thomasf10/bachelorproef_billy/Foto's en video's/IMG_20190320_094348.jpg

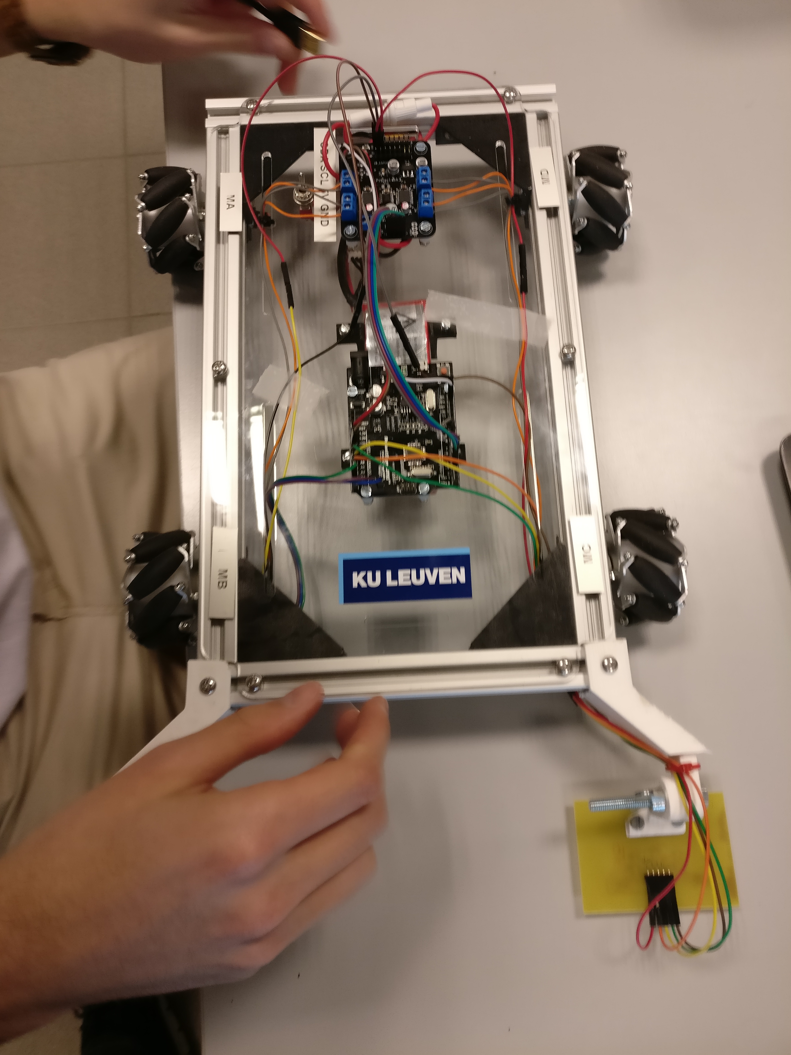
Foto's en video's/IMG_20190320_094348.jpg
