thomasf10/bachelorproef_billy/overzicht_gebruikte_pinnen.txt

chip:atmega328p-au 
pinnen:

1: D3:pwm| GEBRUIKT VOOR MOTORSHIELD				
2: D4 :WERKT OP PRINT
3: GND
4: VCC
5: VCC
6: VCC
7: XTAL1
8: XTAL2
9: D5:pwm| GEBRUIKT VOOR MOTORSHIELD
10: D6: pwm| GEBRUIKT VOOR MOTORSHIELD
11: D7 :WERKT OP PRINT
12: B0 (digitale i/o 8) | GEBRUIKT VOOR RFID RESET  :WERKT OP PRINT : moet misschien pwm pin zijn voor rfid!!!!!
13: B1:pwm (digitale i/o 9)| GEBRUIKT VOOR MOTORSHIELD
14: B2 (digitale i/o 10) | GEBRUIKT VOOR RFID SDA :WERKT OP PRINT
15: B3: pwm: mosi  (digitale i/o 11) | GEBRUIKT VOOR RFID MOSI :WERKT OP PRINT
16: B4: miso  (digitale i/o 12) | GEBRUIKT VOOR RFID MISO  :WERKT OP PRINT
17: B5: sck   (digitale i/o 13) | GEBRUIKT VOOR RFID SCK :WERKT OP PRINT
18: AVCC
19: A6: enkel analog in| GEBRUIKT VOOR SENSOR
20: AREF
21: GND
22: A7: enkel analog in| GEBRUIKT VOOR SENSOR
23: C0: (analog i/o 0)| GEBRUIKT VOOR SENSOR
24: C1: (analog i/o 1)| GEBRUIKT VOOR SENSOR
25: C2: (analog i/o 2)| GEBRUIKT VOOR SENSOR
26: C3: (analog i/o 3)| GEBRUIKT VOOR SENSOR
27: C4: SDA (analog i/o 4)| GEBRUIKT VOOR IO_EXPANDER/MOTORSHIELD
28: C5: SCL (analog i/o 5)| GEBRUIKT VOOR IO_EXPANDER/MOTORSHIELD
29: reset
30: D0: RX :WERKT OP PRINT
31: D1: TX :WERKT OP PRINT
32: D2 :WERKT OP PRINT
