thomasf10/bachelorproef_billy/random/gebruikteComponentenArduinoEnMotorDriver.txt

C:	10 uF		2 	elco's
	0.47 uF		2	elco's
	0.1 uF		3x  	gewoon
	10u		4x	gewoon
	2.2 uF			gewoon	
	100n 		6x	gewoon

pinnetjes

LED:	groen:		1x
	blauw:		4x

TCA9554PWR	2x		(io expander)
TB6612FNG	2x		(motor driver)

Degson input blokje

R:	470		5x
	10k		6x
	1		2x
	1M		1x

switch
Atmega328P-AU
CSTCE16MOV53-RO		oscillatorkristal
NCP1117			5V REGULLATOR --> andere uit labo
LP2985 -33DBVR		3.3 V regulator --> bestellen
