thomasf10/bachelorproef_billy/bachelor proef arno/schema in word.docx

5V naar 3.3 V omzetting

Ontkoppel condensatoren

ON/OFF LED

12V naar 5V omzetting

12V naar 5V omzetting


Pull-up weerstanden

Connectoren

Atmega328P


I/O-expanders


Motor drivers
