thomasf10/bachelorproef_billy/bachelor proef arno/arduino_unoModulo_second_version/models/README

De juiste informatie over componenten vind je op de site:
https://componentsearchengine.com/ga/index.html

Op de site Mouser zou ik de componenten willen bestellen
