thomasf10/bachelorproef_billy/Foto's en video's/IMG_20190306_163210.jpg

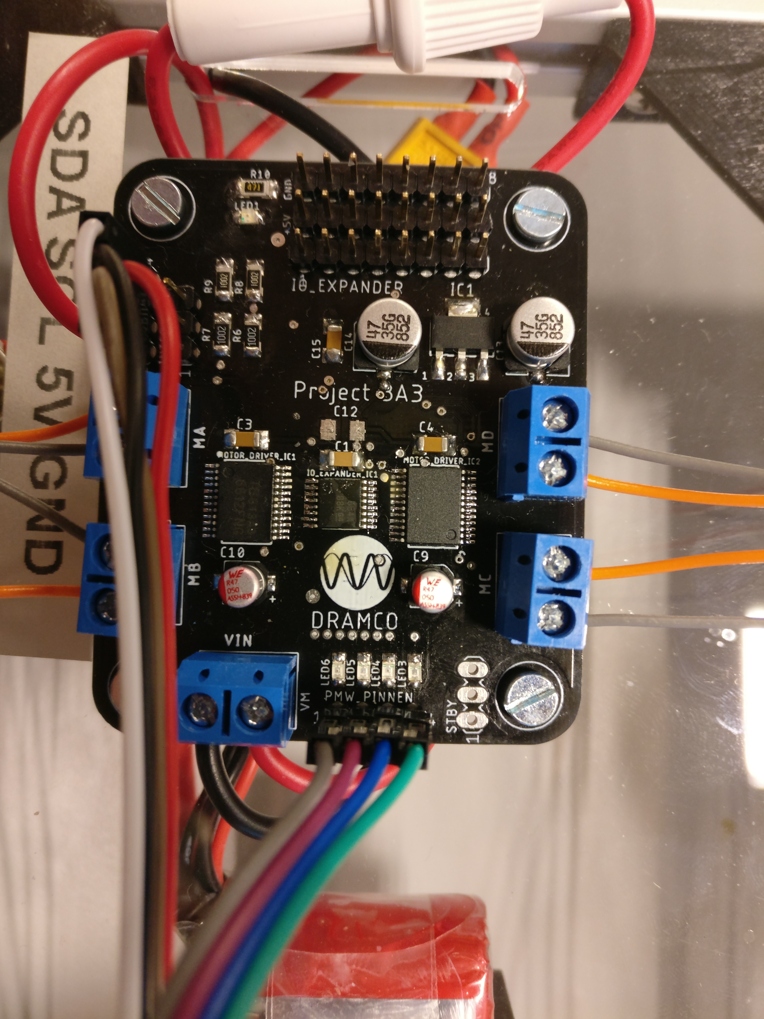
Foto's en video's/IMG_20190306_163210.jpg
