thomasf10/bachelorproef_billy/Foto's en video's/IMG_20190328_161647.jpg

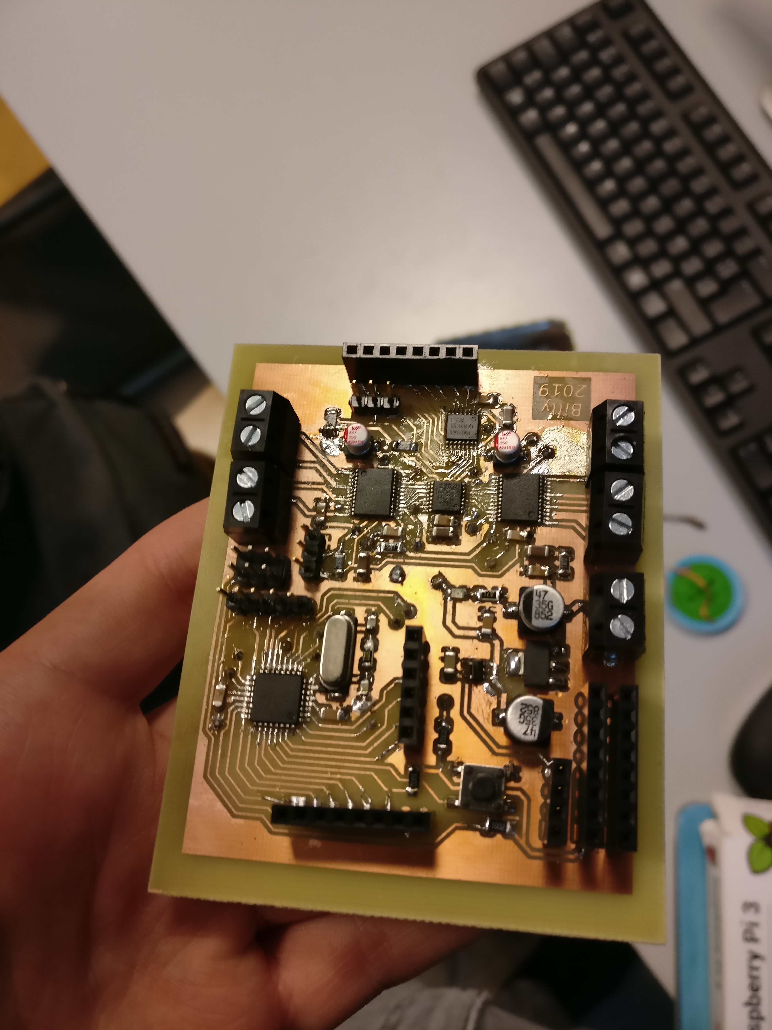
Foto's en video's/IMG_20190328_161647.jpg
