thomasf10/bachelorproef_billy/Foto's en video's/IMG_20190403_132421.jpg

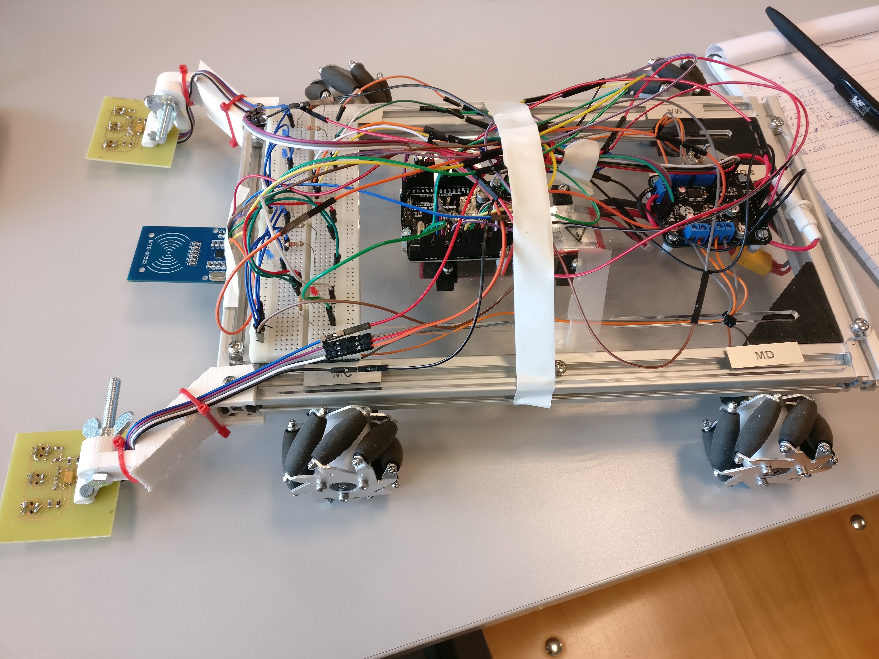
Foto's en video's/IMG_20190403_132421.jpg
