thomasf10/bachelorproef_billy/Foto's en video's/IMG_20190403_160422.jpg

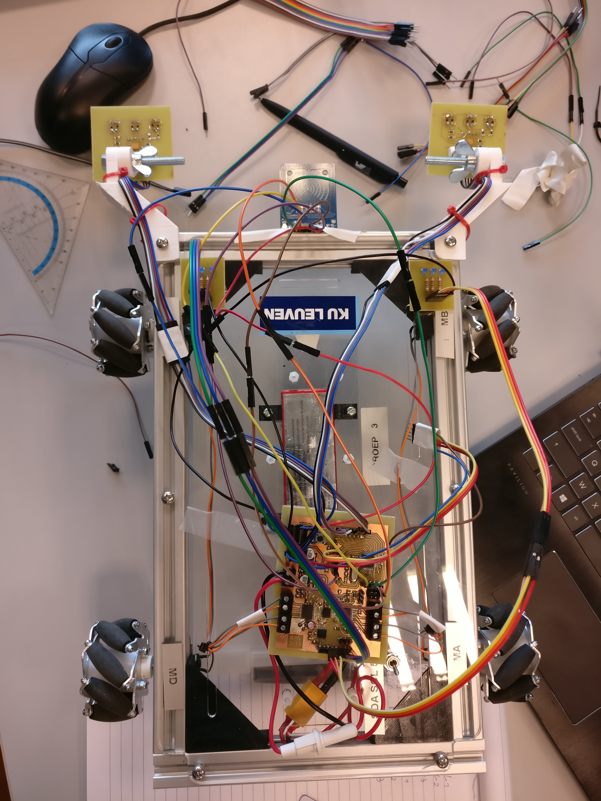
Foto's en video's/IMG_20190403_160422.jpg
