thomasf10/bachelorproef_billy/Foto's en video's/IMG_20190424_135959.jpg

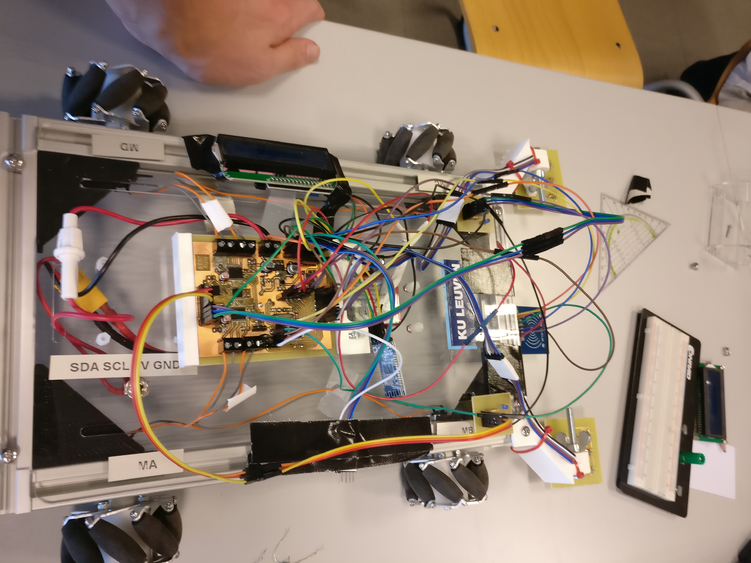
Foto's en video's/IMG_20190424_135959.jpg
