thomasf10/bachelorproef_billy/Foto's en video's/IMG_20190427_100022.jpg

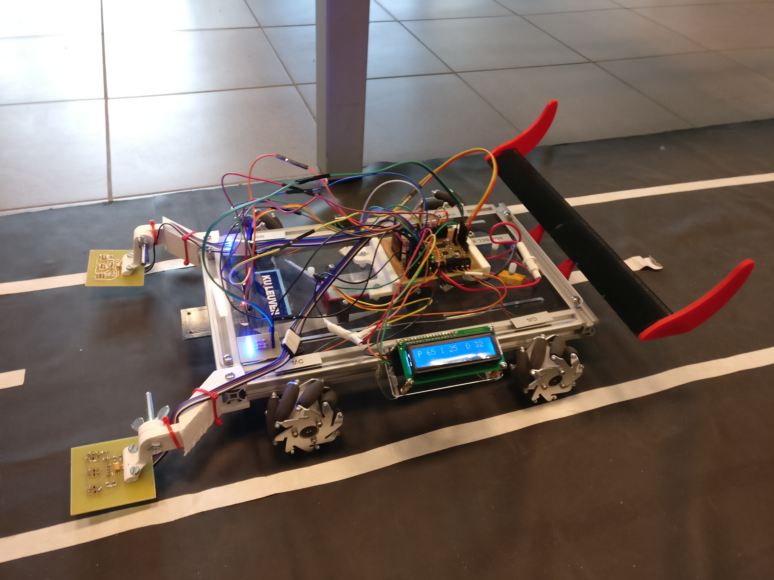
Foto's en video's/IMG_20190427_100022.jpg
