thomasf10/bachelorproef_billy/Foto's en video's/IMG_20190427_101007.jpg

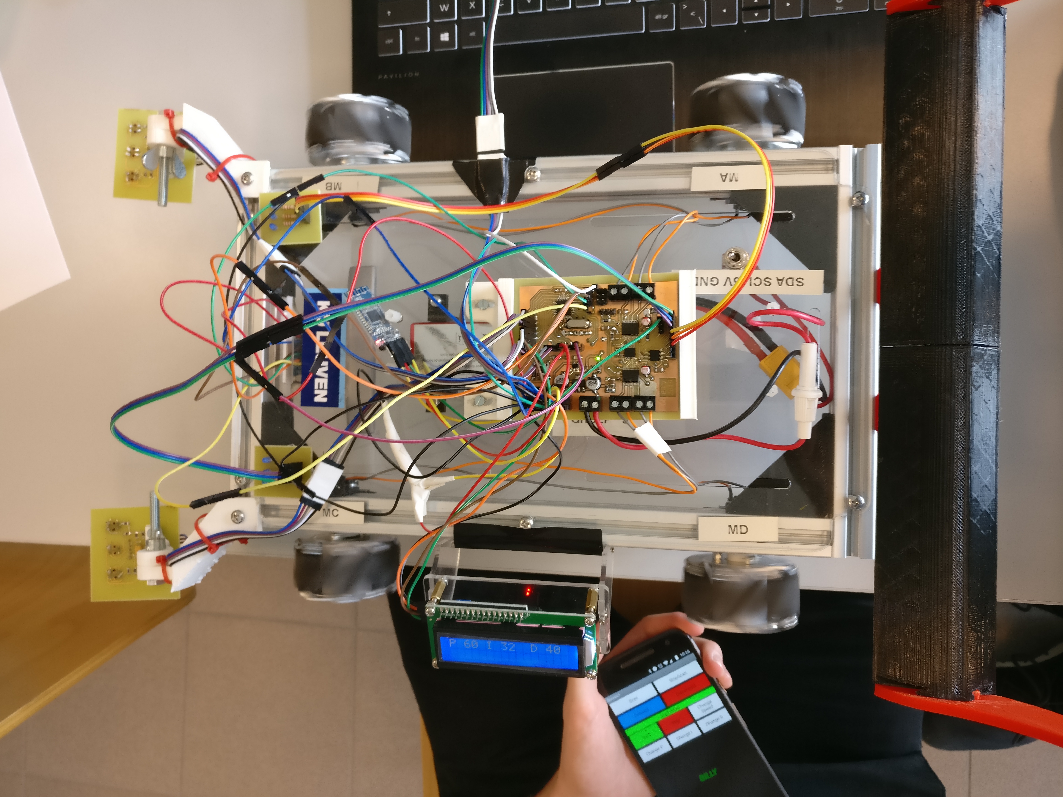
Foto's en video's/IMG_20190427_101007.jpg
