thomasf10/bachelorproef_billy/Foto's en video's/IMG_20190427_141029.jpg

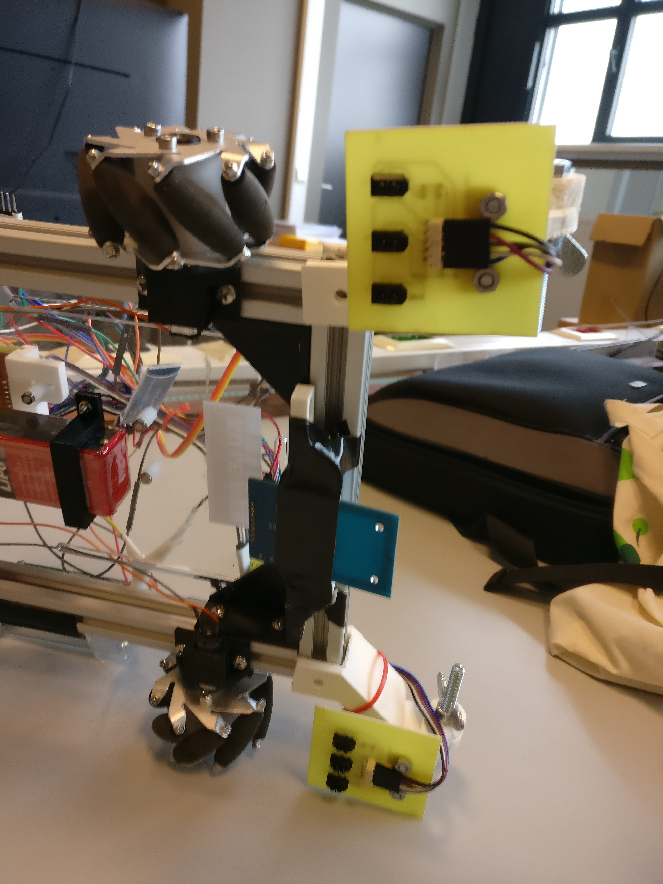
Foto's en video's/IMG_20190427_141029.jpg
