thomasf10/bachelorproef_billy/random/basis_errors.png

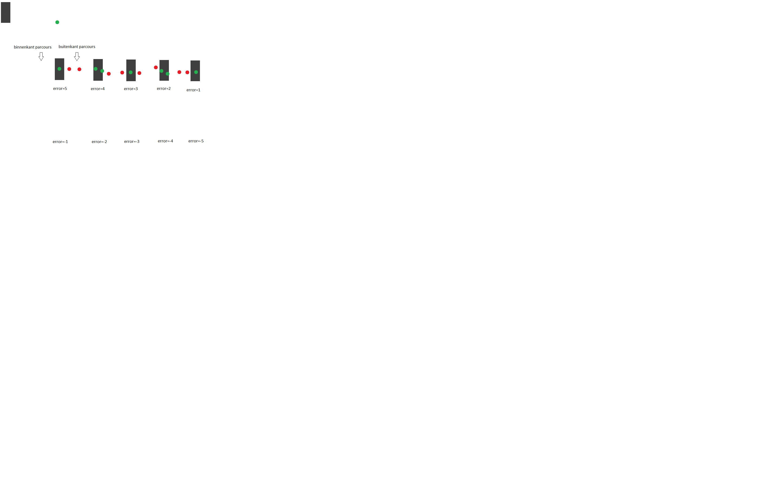
random/basis_errors.png
