thomasf10/bachelorproef_billy/random/Bestellijst1.JPG

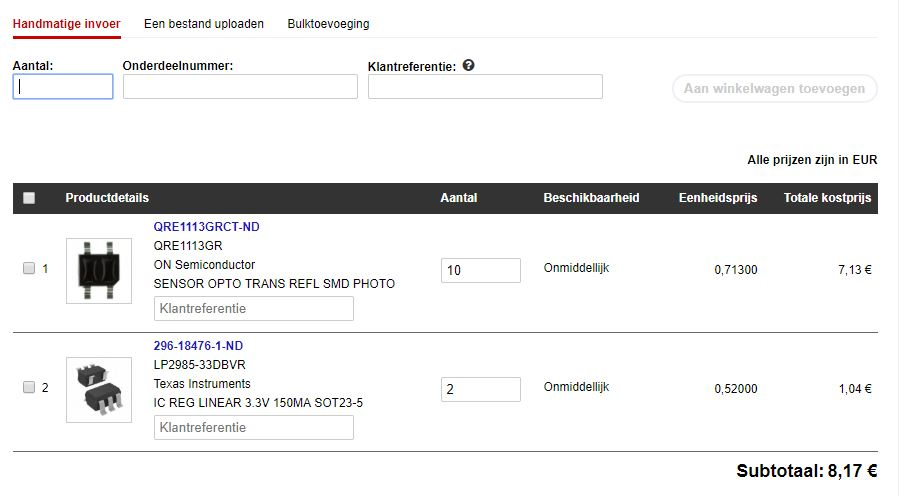
random/Bestellijst1.JPG
