thomasf10/bachelorproef_billy/random/bestellijst2.png

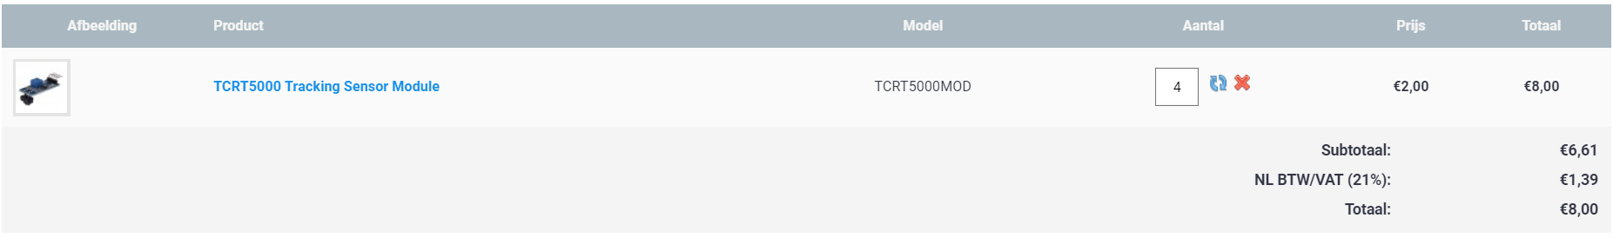
random/bestellijst2.png
