thomasf10/bachelorproef_billy/random/middenlijn.png

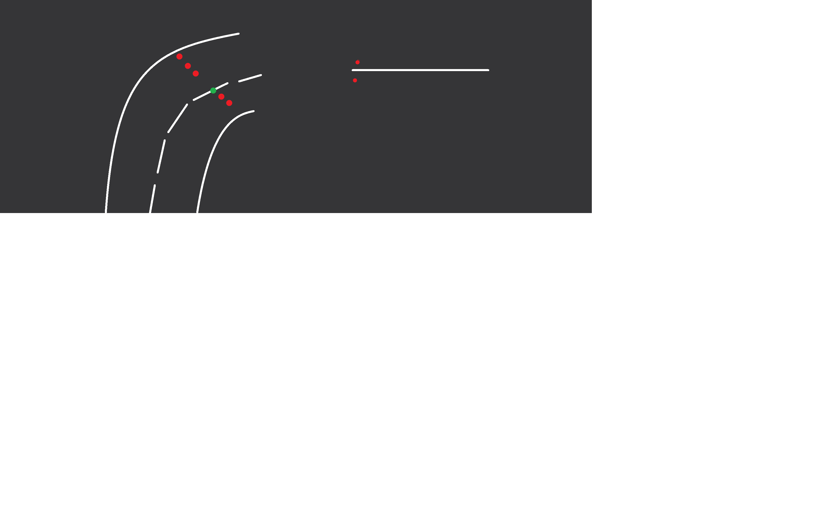
random/middenlijn.png
