thomasf10/bachelorproef_billy/random/rfidaansluiting.PNG

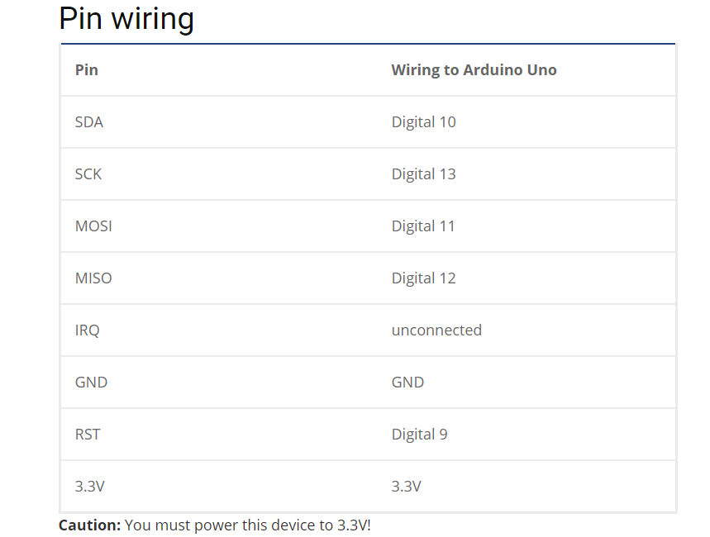
random/rfidaansluiting.PNG
