thomasf10/bachelorproef_billy/skidsteering_idee.PNG

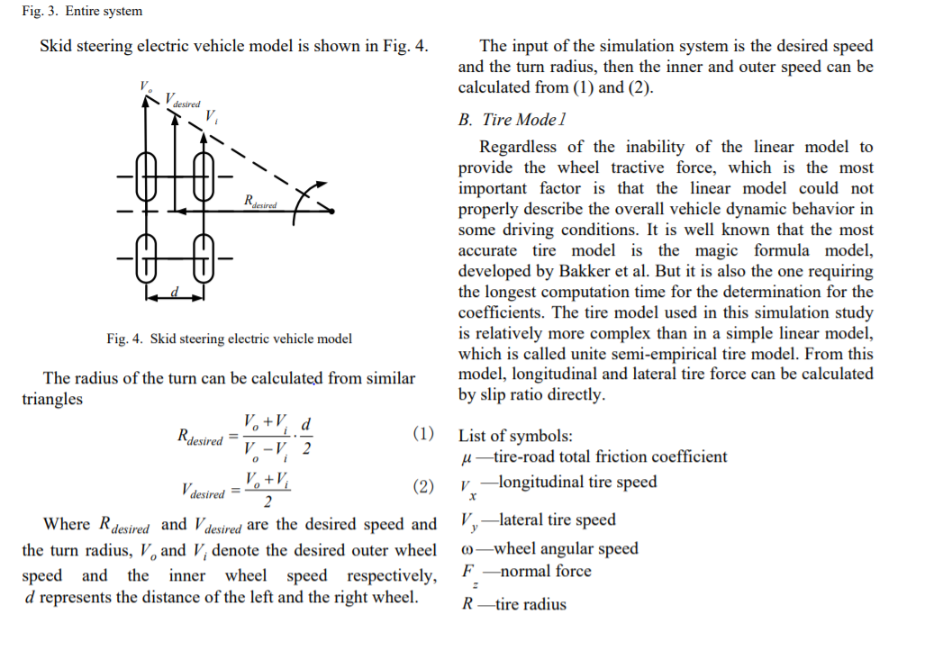
skidsteering_idee.PNG
