thomasf10/bachelorproef_billy/bachelor proef arno/arduino_unoModulo_second_version/models/LIB_ATMEGA328P-AU/ATMEGA328P-AU/3D/ATMEGA328P-AU.stp

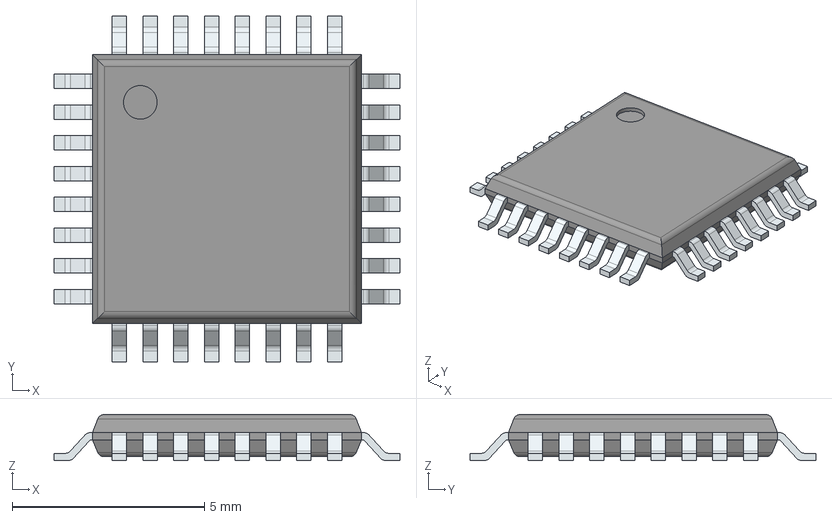
[picture p95: CAD file, 2019-03-08]
bachelor proef arno/arduino_unoModulo_second_version/models/LIB_ATMEGA328P-AU/ATMEGA328P-AU/3D/ATMEGA328P-AU.stp
9.00 x 9.00 x 1.20 mm
PinsArrayLR
PinsArrayTB
