thomasf10/bachelorproef_billy/bachelor proef arno/arduino_unoModulo_second_version/models/LIB_L298P/L298P/3D/L298P.stp

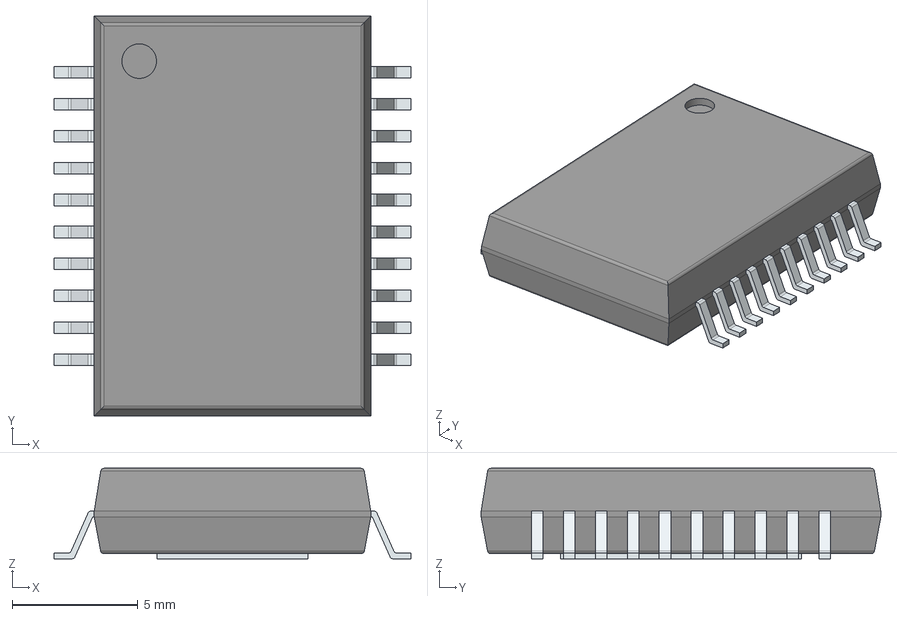
[picture p96: CAD file, 2019-03-08]
bachelor proef arno/arduino_unoModulo_second_version/models/LIB_L298P/L298P/3D/L298P.stp
14.2 x 15.9 x 3.60 mm
PinsArrayLR
ThermalPad
