thomasf10/bachelorproef_billy/bachelor proef arno/arduino_unoModulo_second_version/models/LIB_SK25AHM2G/SK25AHM2G/3D/SK25AHM2G.stp

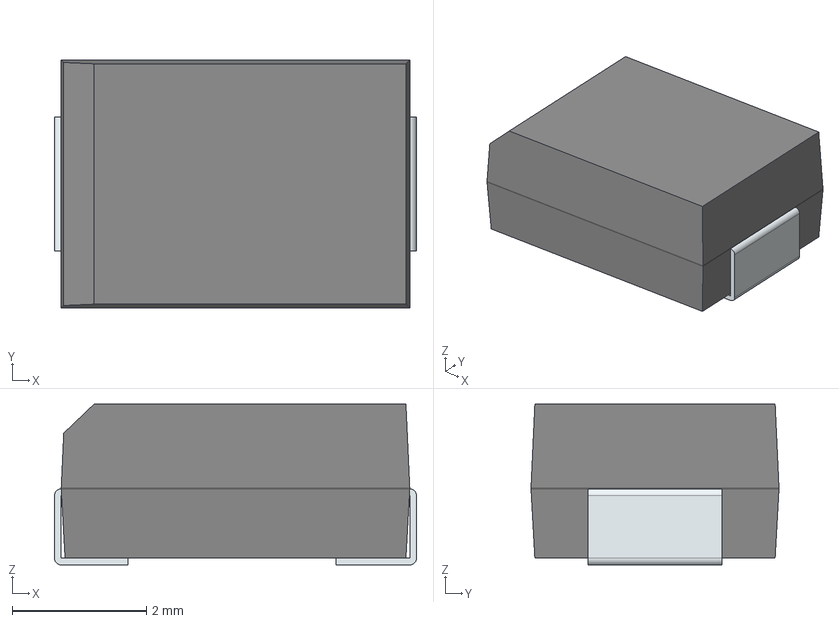
[picture p97: CAD file, 2019-03-08]
bachelor proef arno/arduino_unoModulo_second_version/models/LIB_SK25AHM2G/SK25AHM2G/3D/SK25AHM2G.stp
5.40 x 3.70 x 2.40 mm
FilletPin1
FilletPin2
