thomasf10/bachelorproef_billy/pcbholder/pcbholder.STL

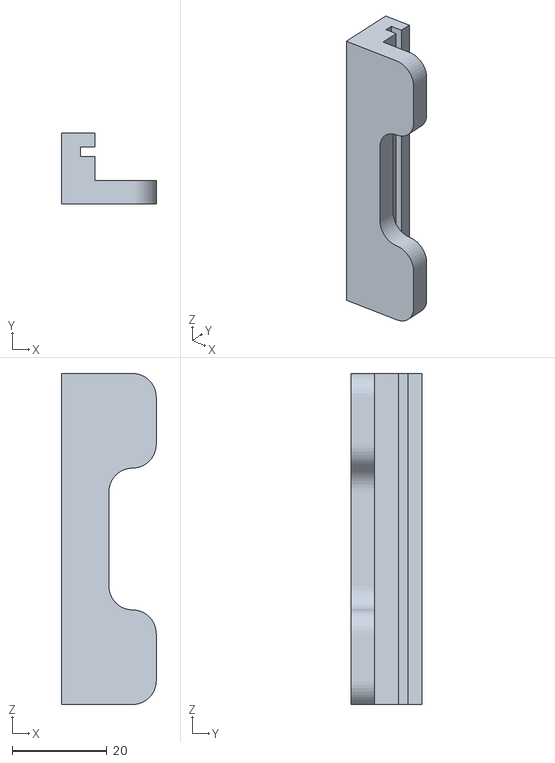
[picture p98: CAD file, 2019-04-03]
pcbholder/pcbholder.STL
20.0 x 15.0 x 70.0
