thomasf10/bachelorproef_billy/random/WielStuk.stl

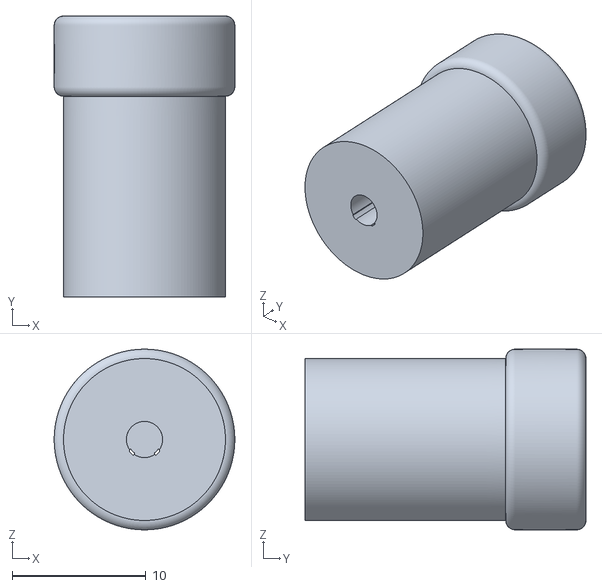
[picture p99: CAD file, 2019-04-30]
random/WielStuk.stl
13.5 x 21.0 x 13.5
