thomasf10/bachelorproef_billy/sensorarm/tussenstukV2.STL

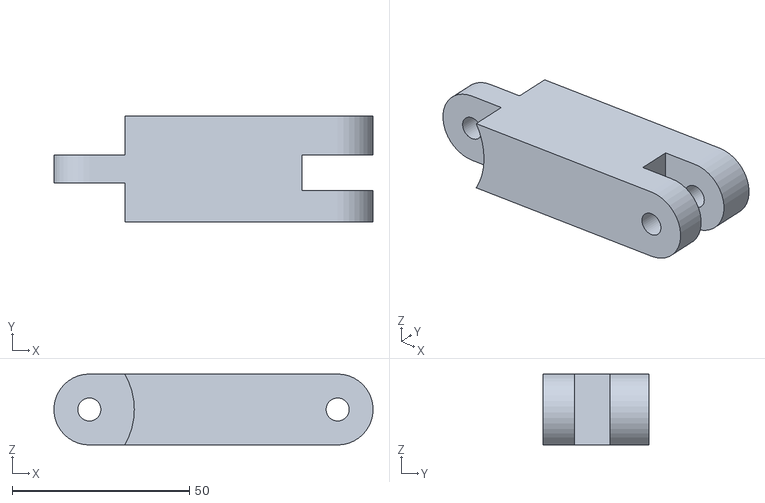
[picture p100: CAD file, 2019-03-06]
sensorarm/tussenstukV2.STL
89.9 x 30.0 x 20.0
