thomasf10/bachelorproef_billy/spoiler/middenstuk._rechts_metegatjevoormartijn.stl

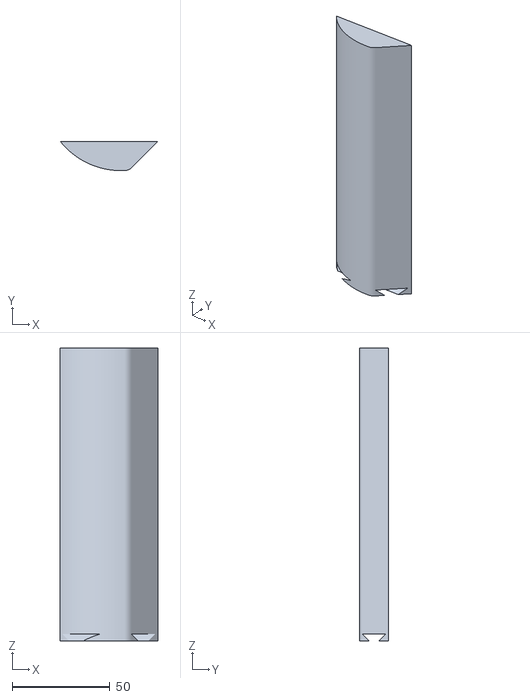
[picture p101: CAD file, 2019-04-27]
spoiler/middenstuk._rechts_metegatjevoormartijn.stl
50.0 x 15.0 x 150.0
