thomasf10/bachelorproef_billy/pcbholder/pcbholder/pcbholder2.SLDPRT

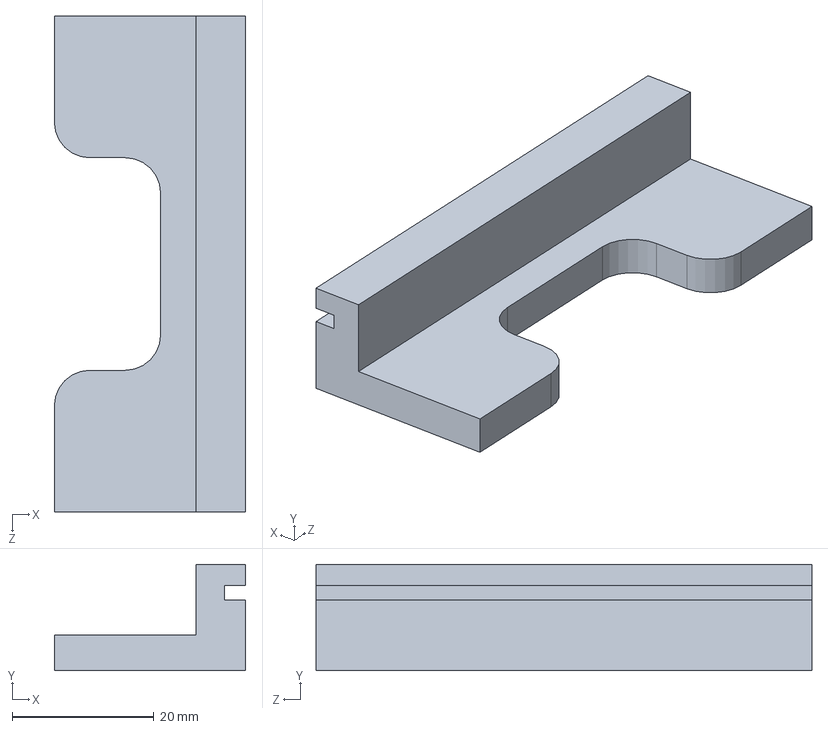
[picture p102: CAD file, 2019-04-03]
pcbholder/pcbholder/pcbholder2.SLDPRT
27.0 x 15.0 x 70.0 mm
