thomasf10/bachelorproef_billy/sensorarm/connector_aan_sensormoduleV2.STL

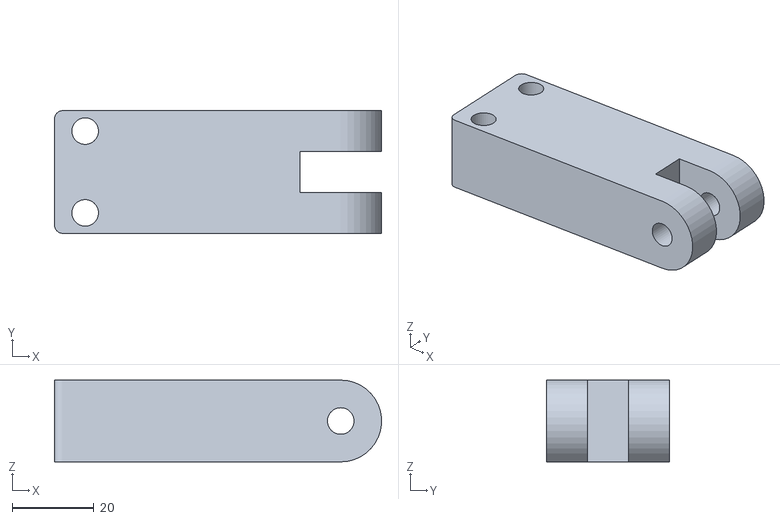
[picture p103: CAD file, 2019-03-06]
sensorarm/connector_aan_sensormoduleV2.STL
80.0 x 30.0 x 20.0
