thomasf10/bachelorproef_billy/spoiler/connector.stl

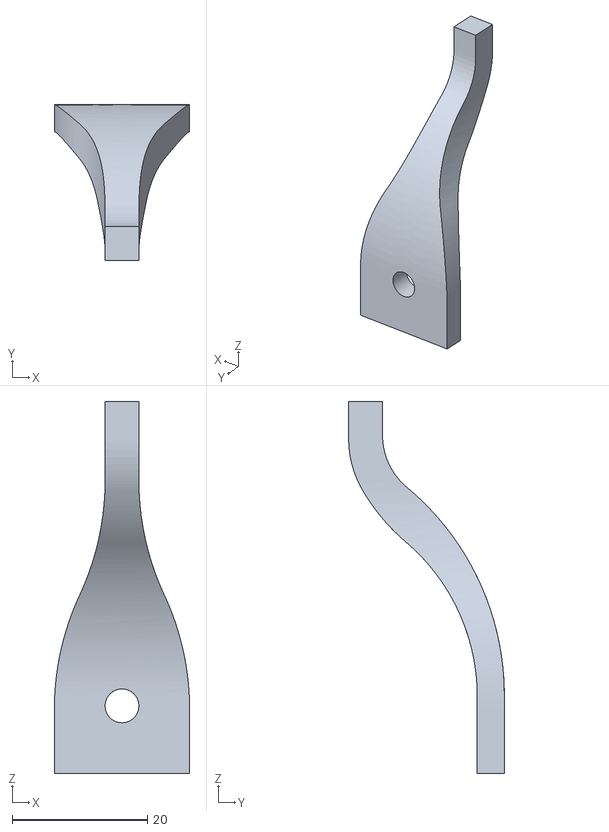
[picture p104: CAD file, 2019-04-16]
spoiler/connector.stl
20.0 x 23.0 x 55.0
