thomasf10/bachelorproef_billy/spoiler/linker_vleugel.stl

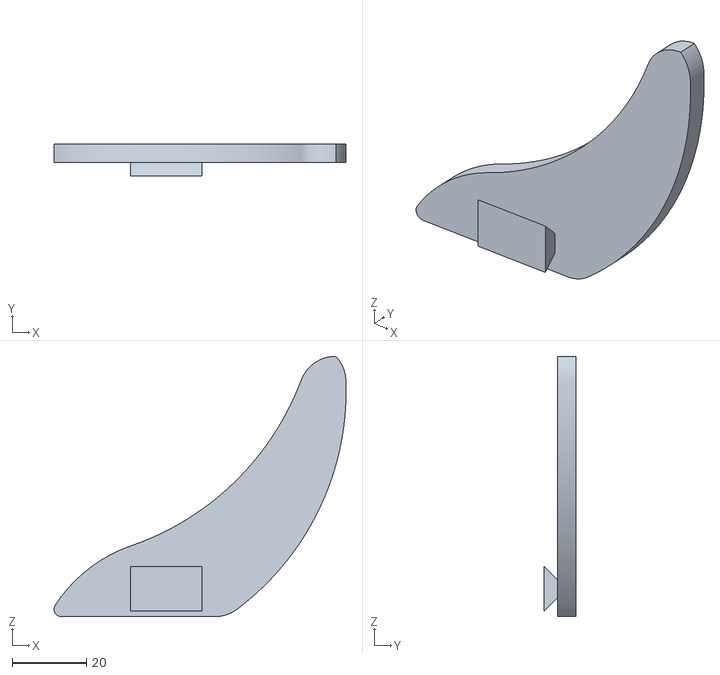
[picture p105: CAD file, 2019-04-16]
spoiler/linker_vleugel.stl
78.5 x 8.54 x 70.0
