thomasf10/bachelorproef_billy/spoiler/middenstuk.stl

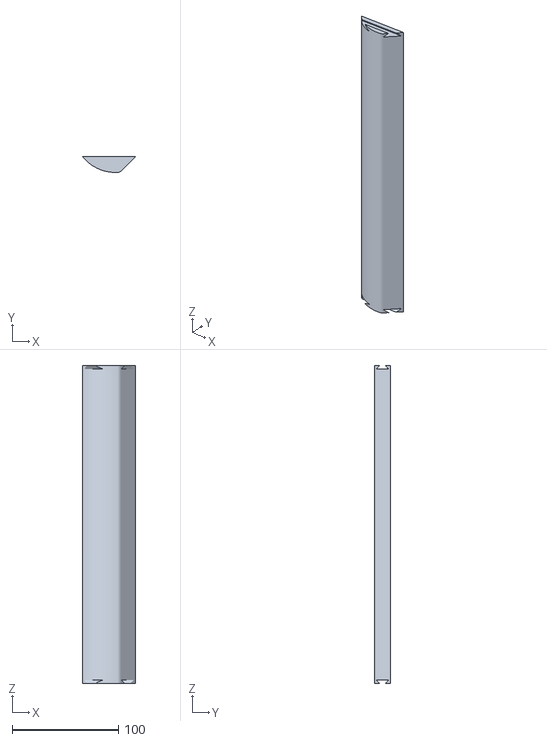
[picture p106: CAD file, 2019-04-16]
spoiler/middenstuk.stl
50.0 x 15.0 x 300.0
