thomasf10/bachelorproef_billy/(list of files, cad)

Other CAD files:
pcbholder/pcbholder/pcbholder.SLDPRT
pcbholder/pcbholder2.STL
spoiler/middenstuk_links_metegatjevoormartijn.stl
spoiler/middenstuk_links.stl
spoiler/middenstukrechts.stl
spoiler/rechter_vleugel.stl
bachelor proef arno/arduino_unoModulo_second_version/models/LIB_ATMEGA328P-AU/ATMEGA328P-AU/3D/ATMEGA328P-AU.stl
bachelor proef arno/arduino_unoModulo_second_version/models/LIB_L298P/L298P/3D/L298P.stl
bachelor proef arno/arduino_unoModulo_second_version/models/LIB_SK25AHM2G/SK25AHM2G/3D/SK25AHM2G.stl
