thomasf10/bachelorproef_billy/BatteryTester/idee1.PNG

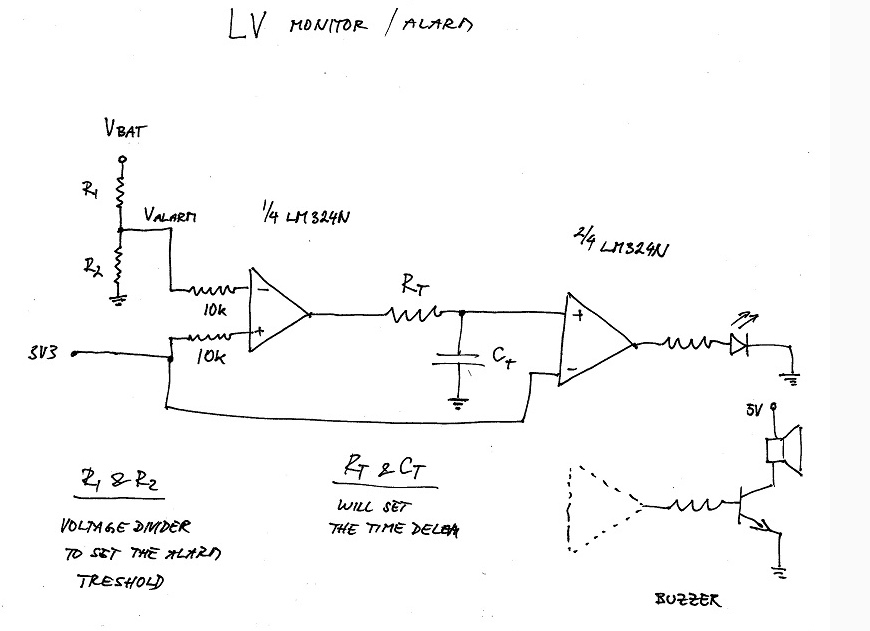
BatteryTester/idee1.PNG
