thomasf10/bachelorproef_billy/BatteryTester/idee2met555.PNG

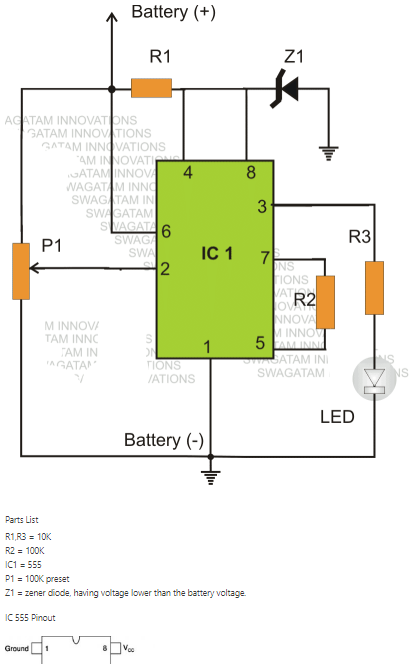
BatteryTester/idee2met555.PNG
