thomasf10/bachelorproef_billy/LEDBoard/pcb.pdf

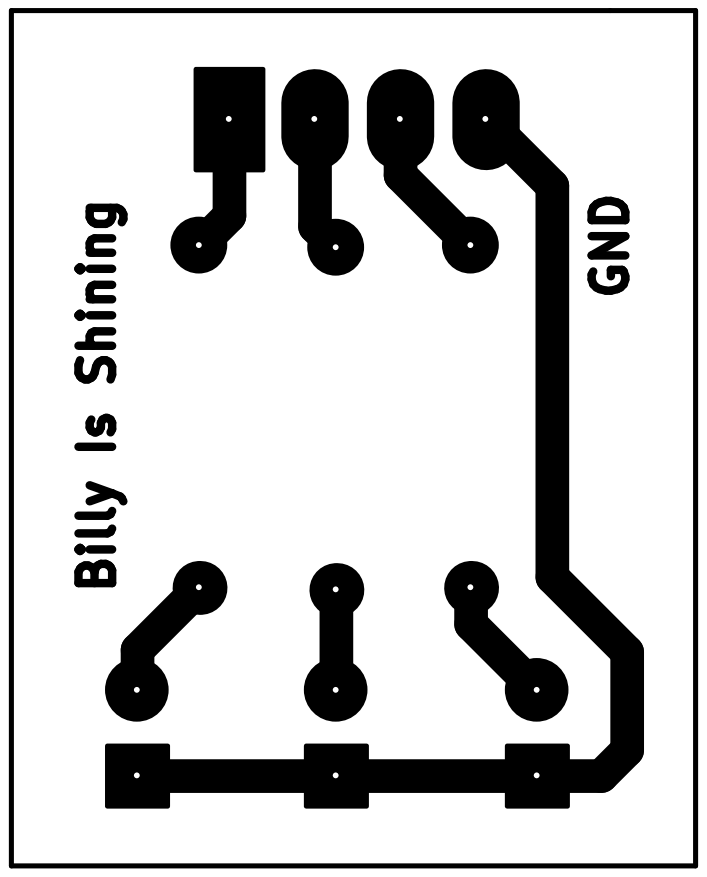
[picture p109: page 1]
