thomasf10/bachelorproef_billy/(list of files, drawings)

Other design files:
random/Line-follower-Feystime/Line follower Feystime/PCB line follower.json
