thomasf10/bachelorproef_billy/code_Thomas/werkendecode_met_bluetooth/include/Sensormodule.h

#ifndef Sensormodule_h
#define Sensormodule_h

#include <arduino.h>

class Sensormodule{
  public:
    Sensormodule();
    Sensormodule(int pinL1,int pinL2, int pinL3, int pinR1, int pinR2, int pinR3);
    void update();
    void print_waarden();
    int calculatepid();
    uint8_t getwaarden();
    void updateleds();
    void set_pid_waarden(int Kp,int Ki,int Kd);
    void print_constanten();
    int getKp();
    int getKi();
    int getKd();
    void resetlasterror();
    void resetovertimeerror();
  private:
    int pinL1,pinL2,pinL3,pinR1,pinR2,pinR3;
    uint8_t waarden;
    int lasterror;
    int overtimeerror;
    int Kp,Ki,Kd;

};
#endif
