thomasf10/bachelorproef_billy/test_nieuwe_sensoren/test_nieuwe_sensoren.ino

void setup() {
  // put your setup code here, to run once:
  Serial.begin(9600);

}

void loop() {
  // put your main code here, to run repeatedly:
 int a1= analogRead(0);
 int a2= analogRead(1);
 int a3= analogRead(2);
  int a4= analogRead(3);
 int a5= analogRead(6);
 int a6= analogRead(7);
 Serial.print(a1 );
 Serial.print(" ");
 Serial.print(a2);
 Serial.print(" ");
 Serial.print(a3);
  Serial.print(" ");
  Serial.print(a4 );
 Serial.print(" ");
 Serial.print(a5);
 Serial.print(" ");
 Serial.print(a6);
 Serial.println();
 
}
