thomasf10/bachelorproef_billy/(commit log)

2019-02-20 motorsturing voorbeeld
2019-02-20 pinnen overzicht
    [_saved_Arduino_Uno_R3_From_Scratch.sch]
2019-02-20 linefollower van vriend
    [PCB line follower.json]
2019-02-20 sensor module
    [Driver.sch, _saved_Arduino_Uno_R3_From_Scratch.sch, sensormodule.kicad_pcb, sensormodule.sch]
2019-02-27 overbodige weg
    [ATMEGA16U2-2018-11-06-15-02-51.sch, ATMEGA16U2.sch, ATMEGA328P-2018-11-06-15-02-51.sch, ATMEGA328P.sch, Arduino_Uno_R3_From_Scratch-2018-11-06-15-02-51.sch, Arduino_Uno_R3_From_Scratch.sch, DecouplingCapacitors.sch, Driver.sch]
2019-02-27 pcbarduino
    THT atmega aangepast naar smd en volledig schema afgewerkt
    [ATMEGA328P.sch]
2019-02-27 sensortest
    sensor test
    [_saved_sensormodule.sch]
2019-02-27 sensorss
    s
    [sensormodule.kicad_pcb, sensormodule.sch]
2019-02-27 sens
    se
    [sensormodule.kicad_pcb]
2019-02-27 schema Afgewerkt
    [ATMEGA328P.sch, Arduino_Uno_R3_From_Scratch.sch, Headers.sch, MotorDriver.sch, _saved_Arduino_Uno_R3_From_Scratch.sch]
2019-02-27 bestellijst+pcbvoltageregulator aangepast
    [ATMEGA328P.sch, Headers.sch, IOExpander.sch, LEDs.sch, Voltage_Regulator.sch, _saved_Arduino_Uno_R3_From_Scratch.sch, connectorenMotorDriverBoard.sch, voltage_management.sch]
2019-02-27 probeersel code met interrupt en uitleg
2019-03-01 overzicht
    alles in mappen+pin overzicht
    [PCB line follower.json, sensormodule.kicad_pcb, sensormodule.sch]
2019-03-01 sensormodule
    pcb sensor met 3 sensoren
    [sensormodule.sch]
2019-03-01 sensor arm
    verstelbare arm
2019-03-01 arm
    klaar
    [volledig.cfg]
2019-03-02 print
    mounting holes
    [sensormodule.kicad_pcb]
2019-03-05 n
    f
    [volledig.cfg]
2019-03-06 TekeningAfenGecontroleerd
    nu nog componenten toevoegen en routen
    [ATMEGA328P.sch, Arduino_Uno_R3_From_Scratch.sch, DecouplingCapacitors.sch, Headers.sch, IOExpander.sch, LEDs.sch, MotorDriver.sch, PullUpResisters.sch]
2019-03-06 sens
    code
    [connector_aan_sensormoduleV2.STL, tussenstukV2.STL]
2019-03-06 d
    d
    [volledigrechts.cfg]
2019-03-08 versie van arno
    [ATMEGA16U2.sch, ATMEGA328P-2019-03-08-19-27-21.sch, ATMEGA328P-AU.stl, ATMEGA328P-AU.stp, ATMEGA328P.sch, Arduino_Uno_R3_From_Scratch-2019-03-08-19-27-21.sch, Arduino_Uno_R3_From_Scratch.kicad_pcb, Arduino_Uno_R3_From_Scratch.sch]
2019-03-08 pcb wijziging
    [Arduino_Uno_R3_From_Scratch.kicad_pcb]
2019-03-10 bijna klaar pcb
    nog enkele andere planes toevoegen
    [ATMEGA328P.sch, Arduino_Uno_R3_From_Scratch.kicad_pcb]
2019-03-11 pcbAfgewerktVersie1
    volledig afgewerkte pcb 1e versie
    [Arduino_Uno_R3_From_Scratch-B.Cu.gbr, Arduino_Uno_R3_From_Scratch-B.Mask.gbr, Arduino_Uno_R3_From_Scratch-B.Paste.gbr, Arduino_Uno_R3_From_Scratch-B.SilkS.gbr, Arduino_Uno_R3_From_Scratch-Edge.Cuts.gbr, Arduino_Uno_R3_From_Scratch-F.Cu.gbr, Arduino_Uno_R3_From_Scratch-F.Mask.gbr, Arduino_Uno_R3_From_Scratch-F.Paste.gbr]
2019-03-11 u
    u
    [Arduino_Uno_R3_From_Scratch.kicad_pcb, sensormodule.kicad_pcb]
2019-03-12 todo code
    [Asm1.cfg, sensormodule.kicad_pcb]
2019-03-13 reverted versie
    [Arduino_Uno_R3_From_Scratch.kicad_pcb, sensormodule.kicad_pcb]
2019-03-13 afgewerktepcb
    dikkere banen
    [Arduino_Uno_R3_From_Scratch.kicad_pcb]
2019-03-13 NIEUWE PCB VERSIE
    [ATMEGA328P.sch, Arduino_Uno_R3_From_Scratch.kicad_pcb]
2019-03-13 officieel afgewerkte pcb moter + arduino (versie2)
    [Arduino_Uno_R3_From_Scratch.kicad_pcb, BOM.csv]
2019-03-15 motorclass gefixt
2019-03-16 PCB versie3
    Aanpassingen tips coach --> veel gewijzigd
    [ATMEGA328P.sch, Arduino_Uno_R3_From_Scratch.kicad_pcb, Arduino_Uno_R3_From_Scratch.sch, DecouplingCapacitors.sch, Headers.sch, LEDs.sch, PullUpResisters.sch, Voltage_Regulator.sch]
2019-03-16 versie3 afgewerkt
    [Arduino_Uno_R3_From_Scratch.kicad_pcb]
2019-03-16 BOM file
    [BOM.csv]
2019-03-17 i in pid
2019-03-19 update case and millis
2019-03-20 volledig afgewerkte pcb officieel1
    pads moterdriver kleinver gemaakt om te kunnen afdrukken
    [Arduino_Uno_R3_From_Scratch.kicad_pcb]
2019-03-20 Headervlakken groter gemaakt
    [Arduino_Uno_R3_From_Scratch.kicad_pcb]
2019-03-21 update bedankt yoran voor de support
2019-03-24 nieuwe sens
    [sensormodule.kicad_pcb, sensormodule.sch]
2019-03-25 routing nieuwe sens
    [sensormodule.kicad_pcb]
2019-03-27 het werkp xpppp
2019-04-02 interrupt code
2019-04-02 volledige interrupt code
2019-04-03 IO expander voor leds
2019-04-08 WerkendeBluetoothcode
    Led aan en uit via de app bluetooth terminal
2019-04-16 werkende Bluetooth
    Nog iets raar waardie die P afdrukt ipv I + nog laten wegschrijven in EPROM
2019-04-16 Volledig werkend bluetooth, EEPROM nog optimaliseren voor waarden boven de 256 op te slaan
2019-04-16 Volledige werkende Bluetooth en EEPROM wegschrijving
    Nog enkel Gemaakte app koppelen, werkt nu met de app:Serial Bluetooth monitor
2019-04-27 het werkt woehoeeee
    [full_spoiler.cfg, middenstuk._rechts_metegatjevoormartijn.stl, middenstuk_links_metegatjevoormartijn.stl]
2019-04-28 Kostenberekening volledig
    [kosten.xlsx]
2019-04-29 kosten nog aangevuld met details
    [kosten.xlsx]
2019-04-29 Verslag verder aangevuld
    [kosten.xlsx]
2019-04-30 verslag aanpassing
    [kosten.xlsx]
2019-04-30 kosten excel update
    [kosten.xlsx]
2019-05-08 laatste push xp
    [Arduino_Uno_R3_From_Scratch.kicad_pcb]
